DonJechu/Alt-I_Flight-Computer/(commit log)

2026-06-02 Add first flight data (atl1_flight_20260601.csv)
    [atl1_flight_20260601.csv]
2026-06-02 First flight data
    [atl1_vuelo.csv]
2026-06-02 Update battery specifications
2026-06-03 Fix LIFTOFF_G framing: root cause was under-pressurization, not threshold
    - Note on parachute: clarified fix is proper pressurization with gauge, not lowering threshold
    - FSM diagram: corrected gForce threshold from 1.2G to actual 2.5G
    - Roadmap: updated pressure gauge item to ✅ acquired
2026-06-03 Add firmware v2.1 — LittleFS logging, MPU-6500 patch, dual IIR calibration
    Flight-ready firmware for Atl-I. Key features:
    - LittleFS onboard logging: auto-increment /flight_N.csv, Serial recovery commands
    - MPU-6500 support via Adafruit MPU6050 library (WHO_AM_I=0x70 patch required)
    - BMP280 dual IIR: hardware FILTER_X16 + software alpha=0.8
    - Calibration: 100 warm-up reads discarded + 100 averaged basePressure + 50 groundAltitude offset
    - WiFi disabled on LANDING to reduce current ~180mA → ~20mA
    - LIFTOFF_G=2.5f — root cause of Atl-I V1 non-detection was under-pressurization, not threshold
2026-06-13 docs: correct README to match as-built Atl-1 hardware
    - MCU: ESP32 DevKit (was mislabeled as ESP32-C3)
    - Recovery: passive gravity on flight-1; servo is firmware-defined only,
    planned for Atl-2
    - Power path + onboard-LDO decoupling clarified to match the built board
    - Fixed broken doc links and file paths
    - Trimmed the research section; full methodology and dataset will
    accompany the paper
