DonJechu/Alt-I_Flight-Computer/(notices)

Notices in the files:
README.md:
License: MIT
